AerospaceVillage/avBadge_2023/README.md

# Aerospace Village Badge(s) for Def Con 2023

The repo cotains all of the supporting files for the Aerospace Village badges being made for Def Con 2023. In here you will find the 
following:

- [The Wright Flyer](/Badge/WrightFlyer)   
- [The Wright Stuff](Badge/WrightSpace)
- A number of SAOs the Village is making.
