AerospaceVillage/avBadge_2023/Badge/WrightFlyer/3D_Files/README.md

# Support Files

These files are are to support the additional parts that each badge uses. 

  - 3D printed motor housing
  - Laser cut propellers

## Motor Housing

The intent is that the motor is pressed into the 3D printed housing for a 
tight fit and then the housing itself is used to glue to the actual PCB. 
This allows for added rigidity to house the motor and a stabalizing 
surface area from which to glue. Heating the printed housing up (i.e. using a hot air station)
for a few moments to help soften the material prior to inserting the motor helps ensure no
binding is present. 

## Propellers

The Propellers were cut using the following tools/software:

  - 55w CO2 Laser 
  - Design - Inkscape
  - Laser Cutting File - Lightburn

### Material

[KoskiPly Birch AB/B Plywood - (0.8mm - 2.5mm) Thin 
Stock](https://makerstock.com/products/thinstock-birch-plywood?_pos=1&_sid=d77494df5&_ss=r&variant=32110173126753)
1/16" / 1.5mm / 12"x20"
