AerospaceVillage/avBadge_2023/Badge/WrightSpace/artwork/README.md

# Art to PCB

All of the artwork generously provided by [flysurreal](https://www.flysurreal.com/). This section is used to retain all of the supporting artwork, from the beginning of the creative process all the way to final product.

Using the [svg2mod](https://github.com/svg2mod/svg2mod)

with the command line:

```
svg2mod -c -p 0.5 --format latest Wright\ X3.svg
```
