AerospaceVillage/avBadge_2023/Badge/WrightSpace/WrightSpace.csv

Reference | Value | Footprint | Datasheet | MPN | Qty
BT1 | Battery_Cell | 2479_battery_holder:2479 | ~ |  | 1
C1, C2, C5 | 10uF | Capacitor_SMD:C_0805_2012Metric_Pad1.18x1.45mm_HandSolder | ~ | -- mixed values -- | 3
C3, C4 | 1uF | Capacitor_SMD:C_0805_2012Metric_Pad1.18x1.45mm_HandSolder | ~ | -- mixed values -- | 2
D1-D6 | SunLED_RGB_ReverseMount | sunled:XZMDKCBDDG45S-9 | https://www.sunledusa.com/products/spec/XZMDKCBDDG45S-9.pdf |  | 6
D7-D13 | LED | aerospace_badge:led_in-s124ar | ~ | IN-S124ARUW | 7
J1 | Conn_02x03_Counter_Clockwise | aerospace_badge:esp32_programming_connector | ~ |  | 1
J2 |  | aerospace_badge:sao_1.69 |  |  | 1
J3 |  | Badge_Libraries:Wright X3 |  |  | 1
Q1-Q6 | BC817 | Package_TO_SOT_SMD:SOT-23 | https://www.mccsemi.com/pdf/Products/MMSS8050HE3(SOT-23).pdf | MMSS8050HE3-L-TP | 6
R1, R4, R14, R17, R20, R23 | 150 | Resistor_SMD:R_0805_2012Metric | ~ | RC0805JR-07150RL | 6
R2, R3, R5, R6, R15, R16, R18, R19, R21, R22, R24, R25 | 30 | Resistor_SMD:R_0805_2012Metric | ~ | RC0805FR-0730RL | 12
R7-R9, R26-R28 | 1K | Resistor_SMD:R_0805_2012Metric | https://www.seielect.com/Catalog/SEI-RNCP.pdf | RNCP0805FTD1K00 | 6
R10, R12, R13 | 4.7K | Resistor_SMD:R_0805_2012Metric_Pad1.20x1.40mm_HandSolder | ~ |  | 3
R11 | 10K | Resistor_SMD:R_0805_2012Metric_Pad1.20x1.40mm_HandSolder | ~ |  | 1
R29-R35 | 330 | Resistor_SMD:R_0805_2012Metric_Pad1.20x1.40mm_HandSolder | ~ |  | 7
SW1, SW2 | SW_SPDT | aerospace_badge:switch_JS202011SCQN | ~ | JS202011SCQN | 2
U1 |  | aerospace_badge:R1170X-SOT-89-5 | https://www.nisshinbo-microdevices.co.jp/en/pdf/datasheet/r1170-ea.pdf | R1170H331B-T1-FE | 1
U2 | ESP32-S2-SOLO | Espressif:ESP32-S2-SOLO | https://www.espressif.com/sites/default/files/documentation/esp32-s2-solo_esp32-s2-solo-u_datasheet_en.pdf | ESP32-S2-SOLO-2-N4 | 1
