AerospaceVillage/avBadge_2023/Badge/WrightFlyer/3D_Files/assembly_tool (Meshed).stl

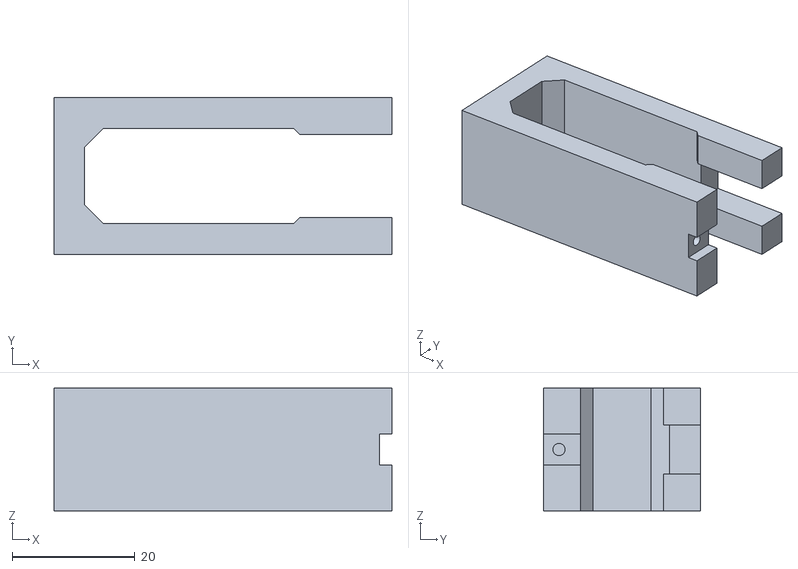
[picture p1: CAD file, 2023-07-25]
Badge/WrightFlyer/3D_Files/assembly_tool (Meshed).stl
55.0 x 25.5 x 20.0
