AerospaceVillage/avBadge_2023/Badge/WrightFlyer/3D_Files/assembly_tool.FCStd

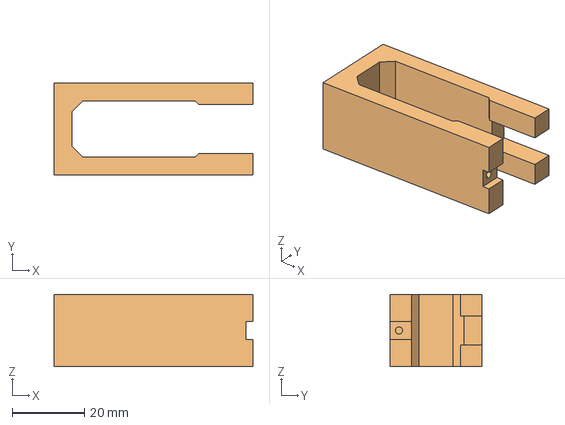
[picture p2: CAD file, 2023-07-25]
Badge/WrightFlyer/3D_Files/assembly_tool.FCStd
55.0 x 25.5 x 20.0 mm
assembly_tool
assembly_tool (Meshed)
