AerospaceVillage/avBadge_2023/Programming/3D/pogo brackets.3mf

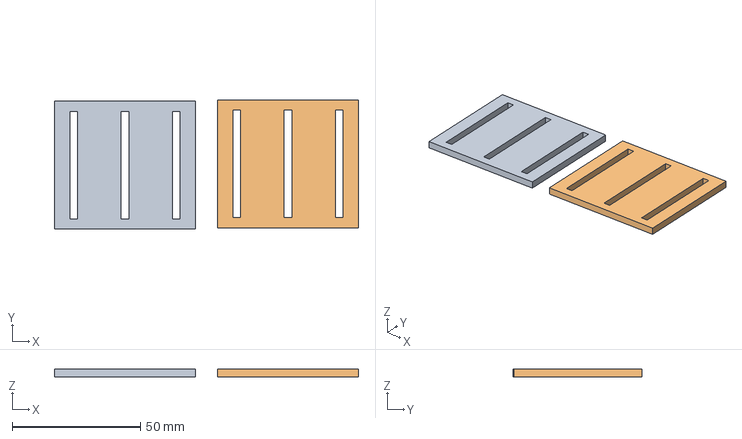
[picture p3: CAD file, 2023-07-28]
Programming/3D/pogo brackets.3mf
118.6 x 50.5 x 3.00 mm
