AerospaceVillage/avBadge_2023/Programming/3D/pogo_jig_parts.FCStd

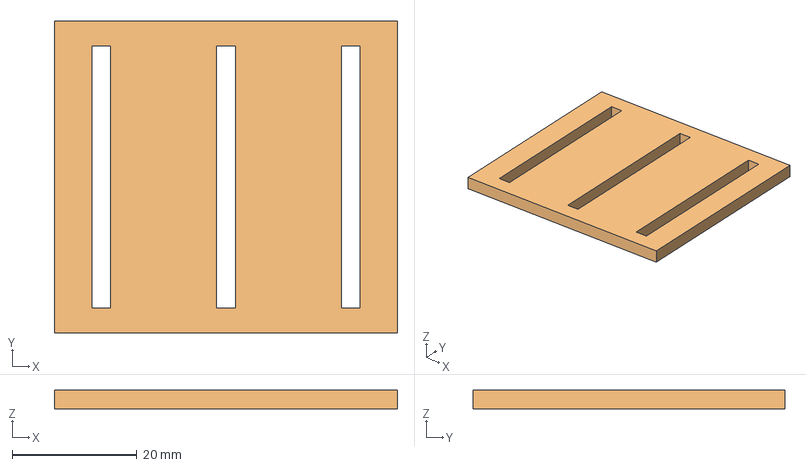
[picture p4: CAD file, 2023-06-27]
Programming/3D/pogo_jig_parts.FCStd
55.0 x 50.0 x 3.00 mm
bracket
bracket (Meshed)
