AerospaceVillage/avBadge_2023/Badge/WrightFlyer/3D_Files/cap (Meshed).stl

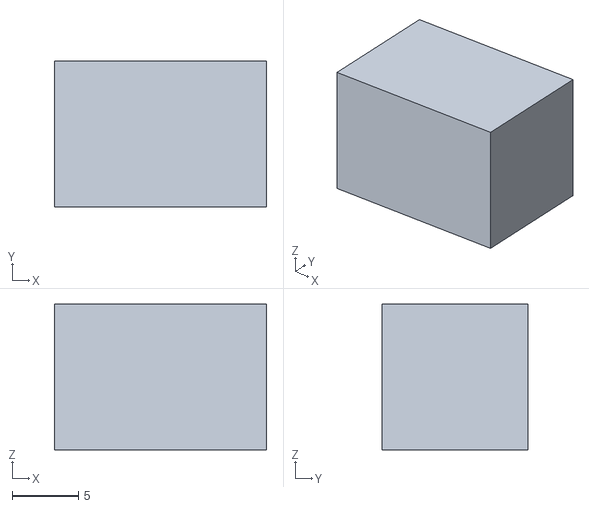
[picture p5: CAD file, 2023-06-27]
Badge/WrightFlyer/3D_Files/cap (Meshed).stl
16.0 x 11.0 x 11.0
