AerospaceVillage/avBadge_2023/Programming/3D/pogo_arm (Meshed).stl

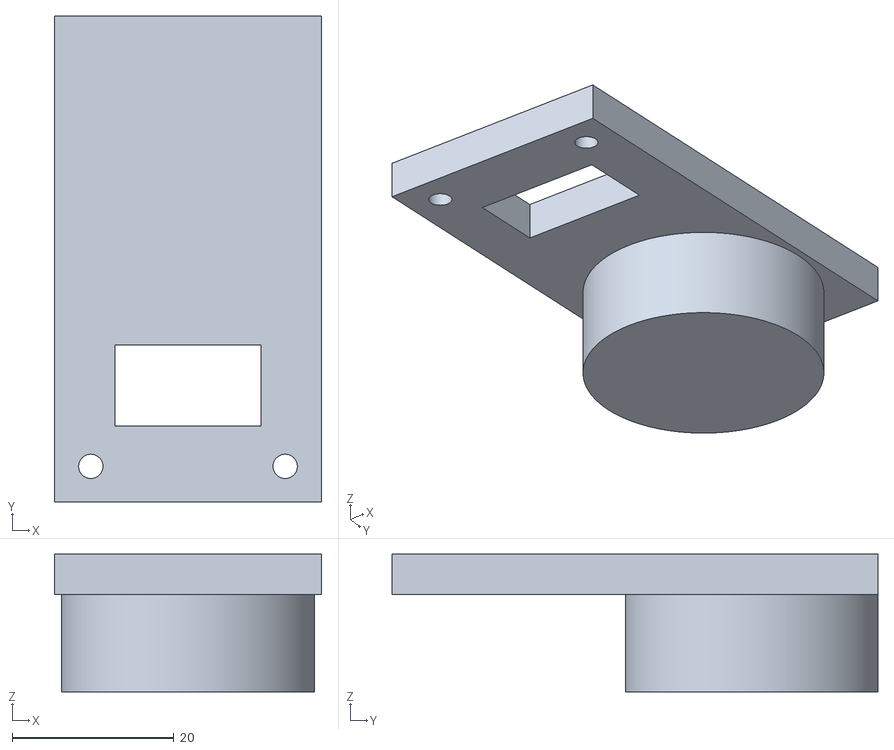
[picture p6: CAD file, 2023-06-25]
Programming/3D/pogo_arm (Meshed).stl
33.0 x 60.0 x 17.0
