AerospaceVillage/avBadge_2023/Badge/WrightFlyer/3D_Files/inner_sleave (Meshed).stl

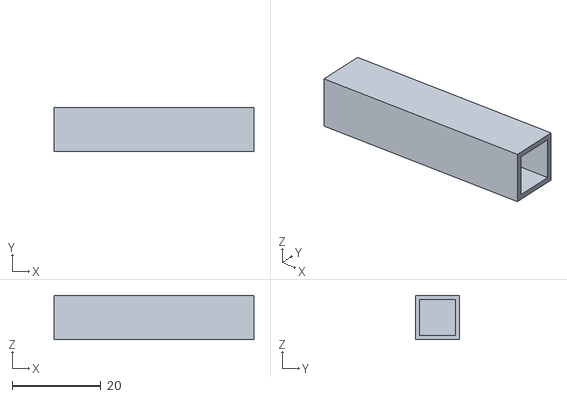
[picture p7: CAD file, 2023-06-27]
Badge/WrightFlyer/3D_Files/inner_sleave (Meshed).stl
45.0 x 10.0 x 10.0
