AerospaceVillage/avBadge_2023/Programming/3D/pogo_clamp (Meshed).stl

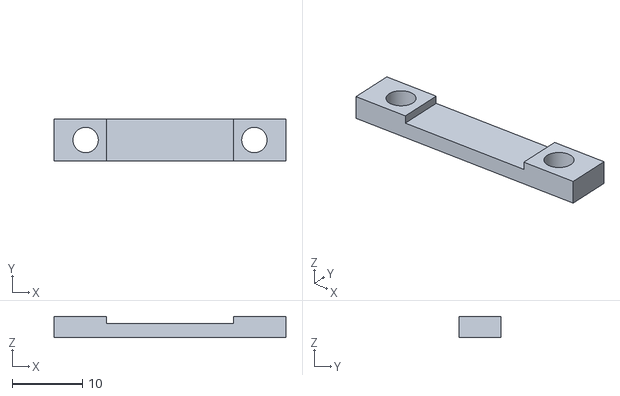
[picture p8: CAD file, 2023-06-25]
Programming/3D/pogo_clamp (Meshed).stl
33.0 x 6.00 x 3.00
