AerospaceVillage/avBadge_2023/Badge/WrightFlyer/3D_Files/propeller_container.FCStd

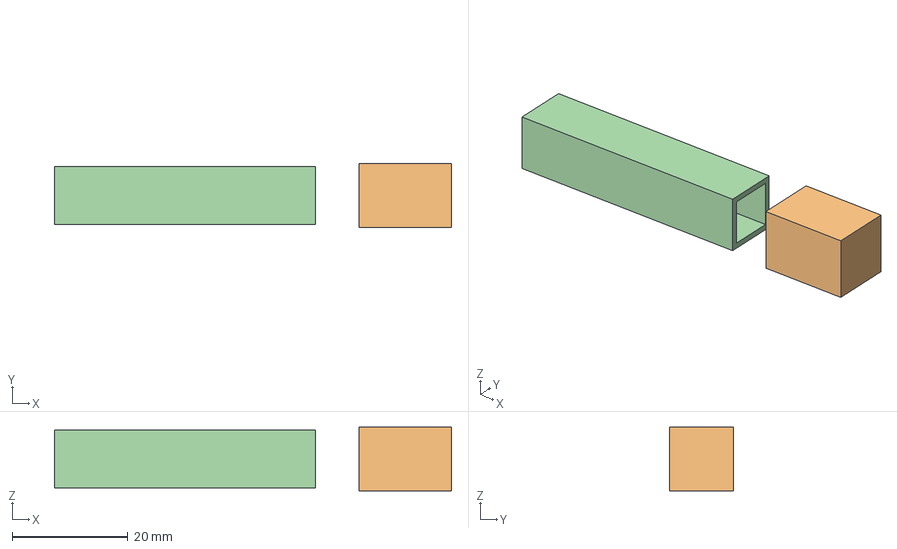
[picture p9: CAD file, 2023-06-27]
Badge/WrightFlyer/3D_Files/propeller_container.FCStd
68.5 x 11.0 x 11.0 mm
inner_sleave
cap
cap (Meshed)
inner_sleave (Meshed)
