AerospaceVillage/avBadge_2023/Programming/3D/tower_base (Meshed).stl

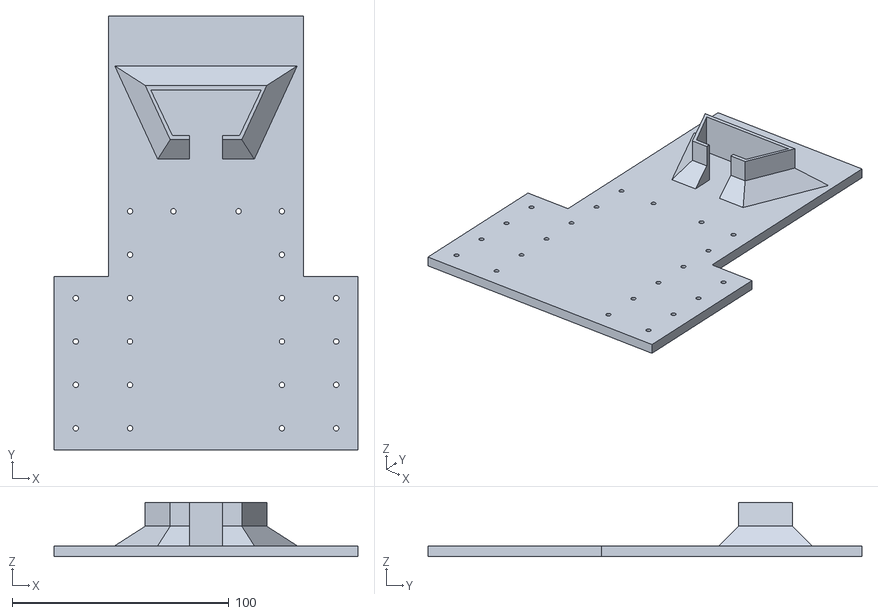
[picture p10: CAD file, 2023-06-25]
Programming/3D/tower_base (Meshed).stl
140.0 x 200.0 x 25.0
