AerospaceVillage/avBadge_2023/Badge/WrightFlyer/3D_Files/Press_component (Meshed).stl

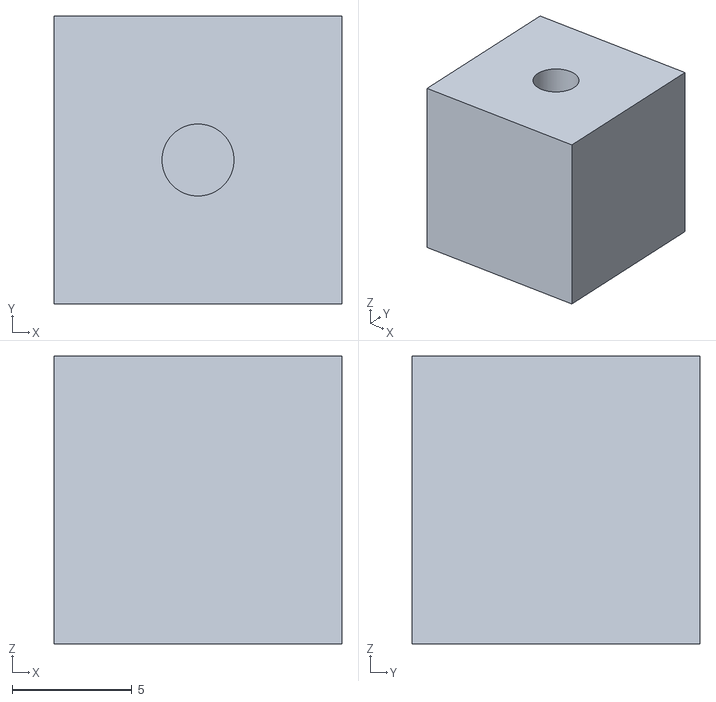
[picture p11: CAD file, 2023-04-16]
Badge/WrightFlyer/3D_Files/Press_component (Meshed).stl
12.0 x 12.0 x 12.0
