AerospaceVillage/avBadge_2023/Programming/3D/bracket (Meshed).stl

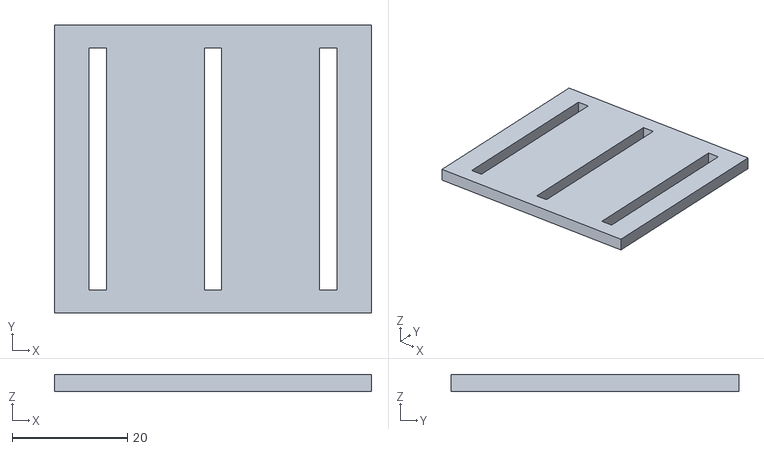
[picture p12: CAD file, 2023-06-25]
Programming/3D/bracket (Meshed).stl
55.0 x 50.0 x 3.00
