AerospaceVillage/avBadge_2023/Badge/WrightFlyer/3D_Files/Propeller_Housing (Meshed).stl

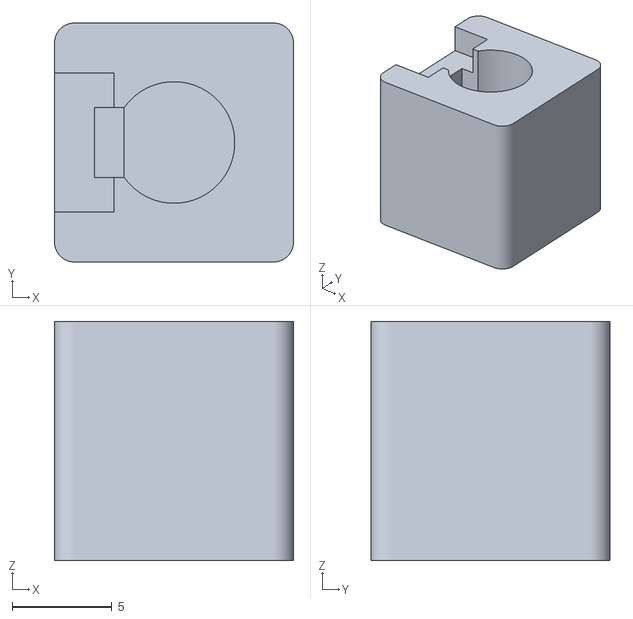
[picture p13: CAD file, 2023-04-16]
Badge/WrightFlyer/3D_Files/Propeller_Housing (Meshed).stl
12.0 x 12.0 x 12.0
