AerospaceVillage/avBadge_2023/Badge/WrightFlyer/3D_Files/propeller_housing.FCStd

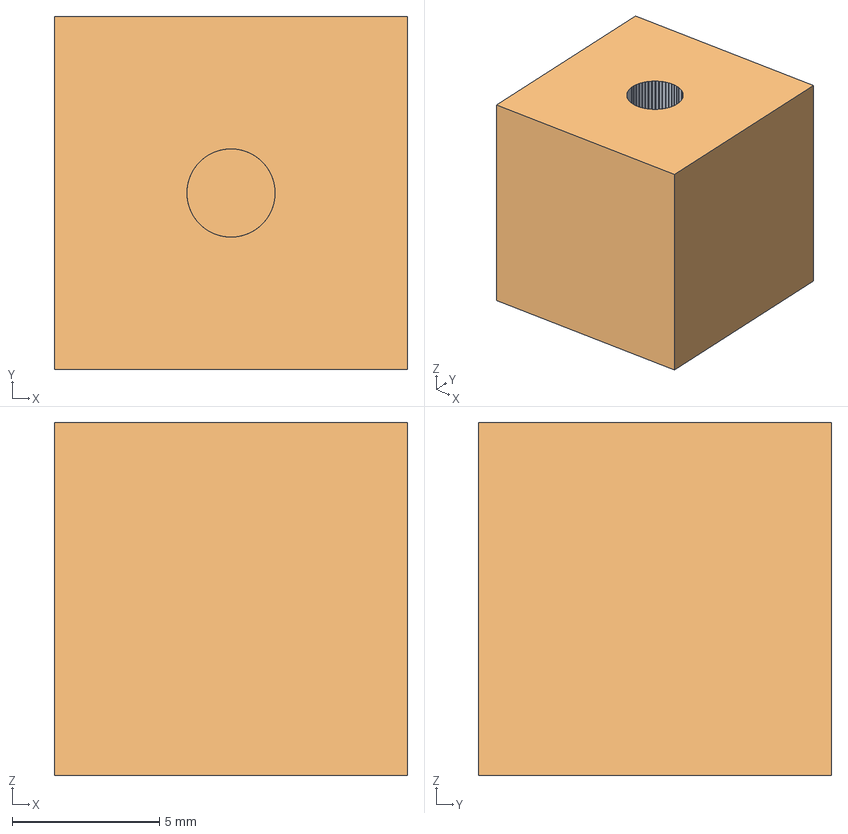
[picture p14: CAD file, 2023-04-16]
Badge/WrightFlyer/3D_Files/propeller_housing.FCStd
12.0 x 12.0 x 12.0 mm
Press_component
Press_component (Meshed)
