AerospaceVillage/avBadge_2023/(list of files, cad)

Other CAD files:
Programming/3D/pogo jig parts.3mf
