AerospaceVillage/avBadge_2023/Badge/WrightFlyer/WrightFlyer.pdf

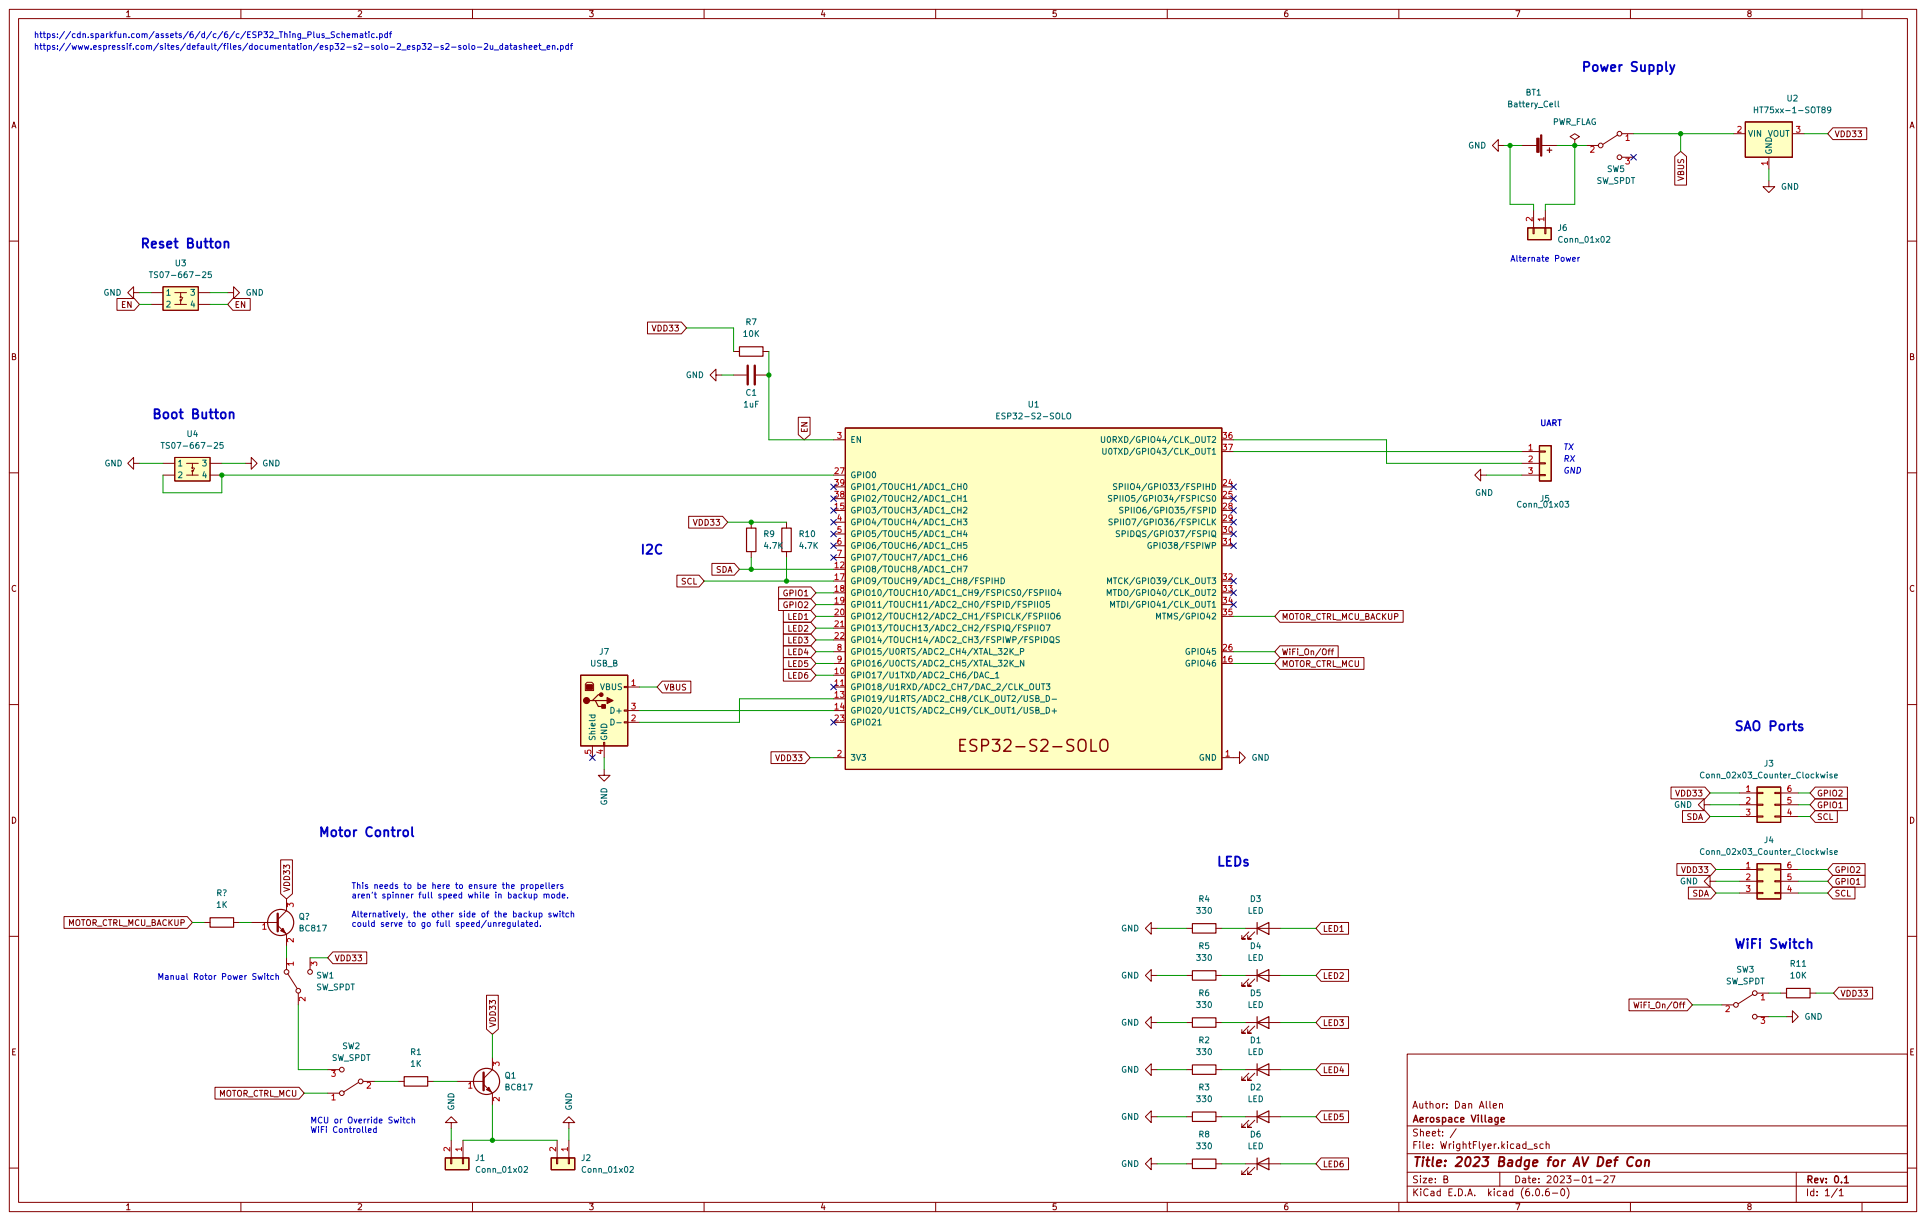
[picture p19: page 1]

https://cdn.sparkfun.com/assets/6/d/c/6/c/ESP32_Thing_Plus_Schematic.pdf
https://www.espressif.com/sites/default/files/documentation/esp32-s2-solo-2_esp32-s2-solo-2u_datasheet_en.pdf

This needs to be here to ensure the propellers
aren't spinner full speed while in backup mode.

could serve to go full speed/unregulated. MCU or Override Switch WiFi Controlled

Alternatively, the other side of the backup switch

Manual Rotor Power Switch

File: WrightFlyer.kicad_sch Sheet: / Aerospace Village Author: Dan Allen

Id: 1/1 Title: 2023 Badge for AV Def Con
