AerospaceVillage/avBadge_2023/Badge/WrightSpace/Arduino/WrightStuff/touch_functions.h

/*
 * Functions to register all the touch point functions internally numbered 1-5
 */

#define touch1 1
#define touch2 2
#define touch3 3
#define touch4 4
#define touch5 5

#define threshold_1 20000     // These need to perhaps be set/tuned to the actual fabricated board once completed.
#define threshold_2 20000
#define threshold_3 20000
#define threshold_4 10000
#define threshold_5 20000

volatile short touch_sum = 0;

volatile boolean pulse_lock = false;
volatile boolean touch2_released = false;

volatile boolean track_lock = false;
volatile boolean touch3_released = false;

volatile boolean play_stop = false;
volatile boolean touch4_released = false;

volatile boolean color_lock = false;
volatile boolean touch5_released = false;


void process_touch1(){
  // The XOR in the interrupt helps reset the function when the touch sensor is released
  touch_sum = touch_sum ^ 1;
}

void process_touch2(){  
  touch_sum = touch_sum ^ 2;
  if( (touch_sum & 2) == 0 and pulse_lock == false){
    touch2_released = true;
  }else{
    touch2_released = false;
  }
}

void process_touch3(){  
  touch_sum = touch_sum ^ 4;
  
  track_lock = !track_lock;
  if( (touch_sum & 4) == 0 and track_lock == false){
    touch3_released = true;
    if(percentage >= 80){
      percentage -= 1;
    }
  }else{
    touch3_released = false;
  }
}

void process_touch4(){    
  touch_sum = touch_sum ^ 8;

  play_stop = !play_stop;
  if( (touch_sum & 8) == 0 and play_stop == false){
    touch4_released = true;
    if(percentage <= 100){
      percentage += 1;
    }  
  }else{
    touch4_released = false;
  }  
}

void process_touch5(){  
  touch_sum = touch_sum ^ 16;
  color_lock = !color_lock;
  if( (touch_sum & 16) == 0 and color_lock == false){
    touch5_released = true;
  }else{
    touch5_released = false;
  }
}


void service_touch_events(){  
	if(touch_sum == 1){
	    // Reset all the things.
	    percentage = 100;
      demo_mode = false;
	    color_index = 0;
      color_ring_color = color_array[color_index];
      alien_color = color_array[color_index];
	    scale = 1;
	    pulse = false;
      alienFound = false;
	}

	else if(touch2_released == true){
		pulse = !pulse;
    touch2_released = false;
   
	}

 else if(touch3_released == true){
  flux_track+= 1;
  if(flux_track > flux_track_limit){
    flux_track = 0;
  }
  touch3_released = false;
  flux_change_track();
 }

 else if(touch4_released == true){
  flux_play_track = !flux_play_track;
  if(flux_play_track == false){
    flux_stop();
  }
  touch4_released = false;
 }

	else if(touch_sum == 18){
		// Means both touch 2 & 5 pressed
		alienFound = true;
    Serial.println("You found an ALIEN! Ensure to report on pirep@aerospacevillage.org {\"XOR\":\"GLENN CURTISS\"}");
	}else if(touch_sum == 24){
		// Means both touch 4 & 5 pressed
		alienFound = false;
	}


	else if(touch5_released == true){
		color_index += 1;
		if(color_index > sizeof(color_array)/sizeof(RGB)){
		  color_index = 0;
		}

		color_ring_color = color_array[color_index];
		touch5_released = false;
	}
}

void setup_touch_interface(){
  touchAttachInterrupt(touch1, process_touch1, threshold_1);
  touchAttachInterrupt(touch2, process_touch2, threshold_2);
  touchAttachInterrupt(touch3, process_touch3, threshold_3);
  touchAttachInterrupt(touch4, process_touch4, threshold_4);
  touchAttachInterrupt(touch5, process_touch5, threshold_5);
}
