AerospaceVillage/avBadge_2023/(commit log)

2023-02-15 updated code with interrupts and schematic to reflect usage of interrupts in backup mode.
    [WrightFlyer.kicad_pcb, WrightFlyer.kicad_sch]
2023-03-12 WiFi switching on/off and Space Shuttle SAO addition.
    [WrightFlyer.kicad_sch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]
2023-03-14 an evenings updates
    [WrightFlyer.kicad_pcb, WrightSpace.kicad_pcb, WrightSpace.kicad_sch]
2023-03-16 updates and v01 sent for fabrication
    [WrightFlyer-B_Cu.gbl, WrightFlyer-B_Mask.gbs, WrightFlyer-B_Paste.gbp, WrightFlyer-B_Silkscreen.gbo, WrightFlyer-Edge_Cuts.gm1, WrightFlyer-F_Cu.gtl, WrightFlyer-F_Mask.gts, WrightFlyer-F_Paste.gtp]
2023-03-16 remove R3 and R4 as redundant
    [WrightFlyer.kicad_sch]
2023-03-17 updated pcb for removal of extra resistors
    [WrightFlyer.kicad_pcb, WrightFlyer.kicad_sch]
2023-03-17 updated programing pin labels
    [WrightFlyer.kicad_pcb, WrightFlyer.kicad_sch]
2023-03-23 shuttle updates for better layout and fabrication ease.
    [space_shuttle_SAO.kicad_pcb]
2023-03-25 fixes to v01 schematic
    [WrightFlyer.kicad_sch, space_shuttle_SAO.kicad_pcb]
2023-03-25 updated Resistor datasheets
    [WrightFlyer.kicad_sch]
2023-03-25 Just some notes
    [WrightFlyer.kicad_sch]
2023-03-25 updated wiring notes
    [WrightFlyer.kicad_sch]
2023-03-26 nearly complete with v02
    [WrightFlyer.kicad_pcb, WrightFlyer.kicad_sch]
2023-03-26 pencils down v02 WrightFlyer, v06 Shuttle SAO
    [WrightFlyer-B_Cu.gbl, WrightFlyer-B_Mask.gbs, WrightFlyer-B_Paste.gbp, WrightFlyer-B_Silkscreen.gbo, WrightFlyer-Edge_Cuts.gm1, WrightFlyer-F_Cu.gtl, WrightFlyer-F_Mask.gts, WrightFlyer-F_Paste.gtp]
2023-03-27 updated datasheet link
    [WrightFlyer.kicad_sch]
2023-04-02 weekend updates to Wright Stuff
    [WrightSpace.kicad_sch, space_shuttle_SAO.kicad_sch]
2023-04-02 updated schematics
    [WrightSpace.kicad_sch]
2023-04-03 updated footprint for linear voltage regulator on both badges
    [WrightFlyer.kicad_pcb, WrightFlyer.kicad_sch, WrightSpace.kicad_sch]
2023-04-06 refined artwork and poc WrightStuff
    [WrightFlyer.csv, WrightSpace.kicad_sch, space_shuttle_SAO.csv]
2023-04-06 artwork tweaks to get more into KiCad
    [WrightSpace.kicad_sch]
2023-04-11 updates, prior to fabrication
    [WrightFlyer.kicad_pcb, WrightFlyer.kicad_sch, WrightSpace.kicad_sch]
2023-04-11 adjusted b.cu keepout zone and removed jlc text for macrofab
    [space_shuttle_SAO.kicad_pcb]
2023-04-12 inclusion of defcon logo
    [WrightSpace.kicad_sch]
2023-04-13 transitor additions for LEDs
    [WrightFlyer.kicad_pcb, WrightFlyer.kicad_sch, WrightSpace.kicad_sch]
2023-04-13 v03 of Wright Flyer going to production
    [WrightFlyer-B_Cu.gbl, WrightFlyer-B_Mask.gbs, WrightFlyer-B_Paste.gbp, WrightFlyer-B_Silkscreen.gbo, WrightFlyer-Edge_Cuts.gm1, WrightFlyer-F_Cu.gtl, WrightFlyer-F_Mask.gts, WrightFlyer-F_Paste.gtp]
2023-04-13 Moved PCB origin for better viewing. Updated board setup to reflect colors we plan to use.
2023-04-13 Started HAS4 SAO
    [HAS4_SAO.kicad_pcb, HAS4_SAO.kicad_sch]
2023-04-13 Revert "Moved PCB origin for better viewing. Updated board setup to reflect colors we plan to use."
    This reverts commit 63d2758ee69b1cddeebf09b22992c9ef2cc4c3ff.
2023-04-13 changed board setup to reflect intended colors for the pcb
2023-04-13 Revert "changed board setup to reflect intended colors for the pcb"
    This reverts commit 5224bc50257c8a5a42ae99afbfe1ad0506408114.
2023-04-13 fixed the orientation of the HAS4 logo so it's correct for the back soldermask
2023-04-14 updated with DRC
    [WrightSpace-B_Cu.gbr, WrightSpace-B_Mask.gbr, WrightSpace-B_Paste.gbr, WrightSpace-B_Silkscreen.gbr, WrightSpace-Edge_Cuts.gbr, WrightSpace-F_Cu.gbr, WrightSpace-F_Mask.gbr, WrightSpace-F_Paste.gbr]
2023-04-14 v01 sent to fabrication
    [WrightSpace-B_Cu.gbl, WrightSpace-B_Cu.gbr, WrightSpace-B_Mask.gbr, WrightSpace-B_Mask.gbs, WrightSpace-B_Paste.gbp, WrightSpace-B_Paste.gbr, WrightSpace-B_Silkscreen.gbo, WrightSpace-B_Silkscreen.gbr]
2023-04-16 added READMEs, 3D support for Wright Flyer
    [Press_component (Meshed).stl, Propeller_Housing (Meshed).stl, WrightSpace.csv, propeller_housing.FCStd]
2023-04-17 increased edge cuts offset to meet minimum 0.254mm threshold.
    [space_shuttle_SAO.kicad_pcb]
2023-04-18 changed copper clearance to edge to MacroFab specs
    [space_shuttle_SAO.kicad_pcb]
2023-04-21 v04 of Wright Flyer
    [WrightFlyer.csv, WrightFlyer.kicad_pcb, WrightFlyer.kicad_sch, WrightSpace.csv, WrightSpace.kicad_sch]
2023-04-22 v02 up for final review
    [WrightSpace.kicad_sch]
2023-04-22 Wright Flyer v04
    [WrightFlyer-B_Cu.gbl, WrightFlyer-B_Mask.gbs, WrightFlyer-B_Paste.gbp, WrightFlyer-B_Silkscreen.gbo, WrightFlyer-Edge_Cuts.gm1, WrightFlyer-F_Cu.gtl, WrightFlyer-F_Mask.gts, WrightFlyer-F_Paste.gtp]
2023-04-23 Wright Stuff v02 going to fabrication
    [WrightSpace-B_Cu.gbl, WrightSpace-B_Mask.gbs, WrightSpace-B_Paste.gbp, WrightSpace-B_Silkscreen.gbo, WrightSpace-Edge_Cuts.gm1, WrightSpace-F_Cu.gtl, WrightSpace-F_Mask.gts, WrightSpace-F_Paste.gtp]
2023-04-24 smale changes for new LEDs
2023-04-29 extra webpage buttons
    [WrightSpace.csv]
2023-04-30 v05... fixed unconnected pins to GND
    [WrightFlyer-B_Cu.gbl, WrightFlyer-B_Mask.gbs, WrightFlyer-B_Paste.gbp, WrightFlyer-B_Silkscreen.gbo, WrightFlyer-Edge_Cuts.gm1, WrightFlyer-F_Cu.gtl, WrightFlyer-F_Mask.gts, WrightFlyer-F_Paste.gtp]
2023-05-13 v5.1 on the W.Flyer for updated PHT and updated codebase for W.Stuff
    [WrightFlyer-B_Cu.gbl, WrightFlyer-B_Mask.gbs, WrightFlyer-B_Paste.gbp, WrightFlyer-B_Silkscreen.gbo, WrightFlyer-Edge_Cuts.gm1, WrightFlyer-F_Cu.gtl, WrightFlyer-F_Mask.gts, WrightFlyer-F_Paste.gtp]
2023-05-29 HAS4 SAO work
    [HAS4_SAO.kicad_pcb, HAS4_SAO.kicad_sch]
2023-06-20 UV Printing
2023-06-20 spelling correction in web_server_functions.h
    [web_server_functions.h]
2023-06-22 cable harness instructions
2023-06-25 programming jig additions
    [bracket (Meshed).stl, pogo_arm (Meshed).stl, pogo_clamp (Meshed).stl, pogo_jig_parts.FCStd, tower_base (Meshed).stl]
2023-06-27 software 1.2 ready... propeller 3D parts
    [cap (Meshed).stl, inner_sleave (Meshed).stl, pogo_jig_parts.FCStd, propeller_container.FCStd]
2023-07-25 refining Wright Stuff
    [assembly_tool (Meshed).stl, assembly_tool.FCStd]
2023-07-28 v2 of AV crew SAO for DC31
    [crew-SAO-B_Cu.gbl, crew-SAO-B_Mask.gbs, crew-SAO-B_Paste.gbp, crew-SAO-B_Silkscreen.gbo, crew-SAO-Edge_Cuts.gm1, crew-SAO-F_Cu.gtl, crew-SAO-F_Mask.gts, crew-SAO-F_Paste.gtp]
2023-07-28 HAS4 SAO for DC31
    [HAS4_SAO-B_Cu.gbl, HAS4_SAO-B_Mask.gbs, HAS4_SAO-B_Paste.gbp, HAS4_SAO-B_Silkscreen.gbo, HAS4_SAO-Edge_Cuts.gm1, HAS4_SAO-F_Cu.gtl, HAS4_SAO-F_Mask.gts, HAS4_SAO-F_Paste.gtp]
2023-07-28 3mf files and gcodes for pogo bracket
    [pogo brackets.3mf, pogo jig parts.3mf]
2023-07-28 SAO pin for DC31
    [SAO_pin-B_Cu.gbl, SAO_pin-B_Mask.gbs, SAO_pin-B_Paste.gbp, SAO_pin-B_Silkscreen.gbo, SAO_pin-Edge_Cuts.gm1, SAO_pin-F_Cu.gtl, SAO_pin-F_Mask.gts, SAO_pin-F_Paste.gtp]
2023-07-28 AV speaker SAO for DC31
    [speaker-SAO-B_Cu.gbl, speaker-SAO-B_Mask.gbs, speaker-SAO-B_Paste.gbp, speaker-SAO-B_Silkscreen.gbo, speaker-SAO-Edge_Cuts.gm1, speaker-SAO-F_Cu.gtl, speaker-SAO-F_Mask.gts, speaker-SAO-F_Paste.gtp]
2023-07-28 removed blocky version of HAS4 SAO
    [HAS4_SAO.kicad_pcb, HAS4_SAO.kicad_sch]
2023-08-04 added some debouncing and error correction
    [WrightStuff.ino, touch_functions.h, web_server_functions.h]
2023-08-07 updated twinkle, demo, spelling errors.
    [led_functions.h, touch_functions.h, web_server_functions.h]
